willbpeters/plumb/docs/superpowers/specs/2026-09-15-putting-analyzer-design.md

# Grip-Mounted Putting Stroke Analyzer — Design Specification

**Working name:** Plumb
**Date:** 2026-09-15
**Author:** Will Peters
**Status:** Approved for planning

---

## 1. Overview

A self-contained, battery-powered sensor that mounts in the butt of a putter grip and reports
stroke metrics on an onboard round display immediately after each putt. No phone, no app, no
network connection.

The device consists of two physically separate parts:

- A **puck** — the electronics, display and battery, shared across all putters.
- A **base** — a cheap printed part that is installed semi-permanently in each putter and
  carries the angular index the puck seats against.

The engineering substance of the project is not the hardware. It is the derivation of putter
face orientation from a single 6-axis IMU mounted a meter away from the face, and the
empirical validation of that derivation against an independent reference system.

### 1.1 Goals

1. Report **face angle at impact**, **tempo ratio**, and **stroke path** within 500 ms of
   follow-through, on-device.
2. Achieve validated face-angle accuracy sufficient for coaching use (see §3).
3. Produce a published accuracy study covering blade, mallet and zero-torque putters.
4. Move between putters in under ten seconds with no recalibration.

### 1.2 Non-goals

These are explicitly out of scope and will not be built:

- Companion mobile application.
- Cloud sync, accounts, or session history beyond on-device storage.
- Wi-Fi connectivity of any kind. The radio is disabled in firmware.
- Green reading, break estimation, or make/miss prediction.
- Full-swing (non-putting) analysis. Load cases and sample rates differ substantially.
- Absolute face angle relative to the target line. See §3.3.
- **Numeric quality, skill or "putt score" ratings.** Report, never judge. A device
  that grades a stroke asserts a standard, and 1.8° open is a miss for a tour player and
  a fine putt for most people. The number is reported and the graphic carries the
  intuition. Written into the contract here because a competitor ships a 0–100 score and
  the idea will be re-proposed otherwise — see the 2026-09-22 competitive feature review.

### 1.2.1 Deferred — considered, postponed, not rejected

Distinct from §1.2: these are wanted, but not in the first build.

**Putt distance approximation.** Calibrate before a round by striking putts at a few known
paces — say 5, 10 and 15 — and thereafter estimate distance from the measured stroke.

The measurement side is nearly free. Clubhead speed at impact falls out of `v = ω × r`, the
same relation §7.4 already uses for path, so the device can report impact speed today at no
extra cost. **Impact speed is therefore not deferred — it is a first-build metric.**

Mapping speed to *distance* is the hard part, and it is deferred because it is a different
kind of problem from everything else in this spec. Face angle and tempo are properties of the
putter that a rigid-body argument makes exactly recoverable. Distance is a property of the
**ball, the strike and the green**, and the device measures none of them:

- **Strike quality.** A toe or heel hit transfers less energy for the same clubhead speed. The
  device cannot see where on the face contact happened.
- **Green speed.** The same stroke runs very differently on a Stimp 8 green and a Stimp 12.
- **Slope.** Uphill and downhill change the answer entirely.

Per-round calibration handles green speed, which is why the proposed approach is sound — it
calibrates the one unknown that stays constant for a round. It cannot handle strike quality or
slope.

So it should be built as an **approximation, labelled as one**, and its accuracy target set
after measurement rather than before. It would also be the first metric in this device whose
accuracy depends on the golfer's consistency rather than on the instrument, which is worth
being clear about before it ships.

**Metrics the pipeline nearly already produces.** A 2026-09-22 review of Plus Putt Path
(`2026-09-22-competitive-feature-review-design.md`) found several quantities this device
computes internally and discards. They are listed here rather than in the first build because
promoting them is a scope decision, not a technical one. None requires new sensing.

- **Face-to-path differential.** Face angle minus path direction; both already in
  `StrokeResult`. It is what determines where a putt starts, and it is a relationship between
  two things the device measures rather than a measurement against a reference it lacks. It
  does NOT escape §3.3 — an address-squareness error biases the face term and not the path
  term, so nothing cancels.
- **Face rotation rate at impact.** The gyro reading at the impact sample projected onto
  measured gravity: one dot product, and **no integration at all.** Every other metric here is
  an integral whose budget is dominated by drift; this one is a direct reading of the
  best-characterised channel against a measured 0.22–0.24 dps floor. It may be the most
  accurate number the device can produce. Reporting it is not a putter-type prior — invariant 1
  forbids the algorithm keying off rotation, not the device reporting it.
- **Total face rotation through the stroke.** `twist_angle` over a different interval.
- **Absolute stroke timings.** Backstroke and forward-stroke milliseconds, time to contact, and
  the pause at the top. The state machine has the indices. `StrokeResult` now reports the two
  phase durations as well as their ratio, for the tempo screen; time to contact and the pause
  at the top are not kept. Timing is this device's best-validated axis.
- **Backswing and follow-through length, and their ratio.** Same track machinery as path, but
  far better conditioned: the integration noise that inflates a 6 mm arc is negligible against
  a backswing of a few hundred millimetres. The RATIO is better still, because a pivot-offset
  error scales both lengths nearly equally and largely cancels — so it may be reportable while
  the arc is not. Measure before claiming.
- **Left-handed mirrored mode.** Every screen is framed "left is the target"; for a left-handed
  golfer that is backwards. Pure UI, and a genuine gap rather than a nice-to-have.
- **Compare-to-first-stroke, and local session history.** Permitted by §1.2, which rules out
  cloud sync, accounts and history *beyond* on-device storage — not on-device history itself.

### 1.3 Project positioning

This is a portfolio project whose purpose is to demonstrate depth in embedded systems,
sensor fusion and empirical validation. Where a choice exists between a faster path and a
more defensible one, the more defensible one wins. A finished device with unvalidated
numbers does not satisfy the goal.

---

## 2. Physical principle

For a rigid body, angular velocity is identical at every point. The grip end of a putter
rotates at exactly the same rate as the face, with no dependence on the distance between them.

Consequently:

| Metric | Requires putter geometry | Rationale |
|---|---|---|
| Tempo ratio | No | Pure timing |
| Face angle at impact | No | Angular velocity is position-invariant |
| Stroke path | **Yes** | Translation scales with the sensor-to-face lever arm |

Face angle and tempo are therefore putter-agnostic and require only the fixed rotational
offset between the sensor axes and the face normal. Path requires the lever arm vector `r`
from sensor to sweet spot, which is a per-putter quantity.

For a point P offset by `r` from the sensor S on a rigid body:

```
a_P = a_S + ω̇ × r + ω × (ω × r)
```

This relation is used in two places: to propagate motion from the sensor to the face when
computing path (§7.4), and inverted, to estimate `r` itself during optional auto-calibration
(§8.4).

### 2.1 Putter type is a data difference, not a calibration difference

A zero-torque putter places the head's center of gravity on the shaft axis, so the head has
no inherent tendency to rotate open and closed through the stroke. A blade or face-balanced
mallet places the CG off-axis and does rotate.

This is a difference in the motion the device measures, not in how the device should measure
it. The algorithm must therefore contain **no putter-type priors**: no normalization of face
rotation against expected magnitude, and no segmentation thresholds tuned on rotation
amplitude. A zero-torque putter that produces low face rotation is reporting a correct
result, not a degraded one.

The only per-putter quantities in the system are the clocking offset and the lever arm.

---

## 3. Success criteria

All figures are measured against the reference system described in §10, over the study
design in §10.3.

| Metric | Target |
|---|---|
| Face angle, bias vs reference | ≤ 0.5° |
| Face angle, 95% limits of agreement | ≤ ±1.0° |
| Face angle, test–retest repeatability (remount, same putter) | ≤ 0.5° SD |
| Tempo ratio, absolute error | ≤ 0.05 |
| Path arc magnitude, relative error | ≤ 10% |
| Path direction classification (straight / in-out / out-in) | ≥ 95% agreement |
| Stroke detection, true positive rate | ≥ 98% |
| False stroke triggers | ≤ 1 per 30 min of idle handling |
| Result latency after follow-through | ≤ 500 ms |
| Strokes per charge | ≥ 500 |
| Putter changeover time | ≤ 10 s |

### 3.1 Why path has a looser target

Path is derived from translation, which requires integrating acceleration. Integration of
noisy acceleration accumulates error quadratically in time. A 10% arc-magnitude target is
honest for this sensor placement; a tighter claim would not survive validation.

### 3.2 Why repeatability is listed separately

Test–retest repeatability isolates mounting error from algorithm error. If bias against the
reference is acceptable but repeatability is poor, the mechanical index is at fault, not the
math. These are separately actionable, so they are separately measured.

### 3.3 Declared limitation: face angle is relative to address

The device has no external heading reference. Gravity constrains pitch and roll absolutely
but provides no information about heading, and a magnetometer is unusable next to a steel
putter head.

The device therefore measures **face angle relative to the address position**, treating the
face at address as square. A golfer who addresses the ball with the face 2° open will be
told they delivered a square face on a putt that starts 2° right.

This limitation is inherent to grip-mounted sensing without an external reference. It will be
stated in the user-facing documentation and in the accuracy study, not hidden. An optional
per-putter "square to line" routine (§8.3) lets a user establish an absolute reference against
an alignment stick if they want one.

---

## 4. Hardware

### 4.1 Bill of materials

| Item | Part | Qty | ~Cost |
|---|---|---|---|
| MCU / display / IMU board | Waveshare ESP32-S3-Touch-LCD-1.28 | 1 | $25 |
| Battery | 3.7 V 400 mAh LiPo, protected (PCM), MX1.25 1.25 mm connector | 1 | $8 |
| Retention magnets | N52 neodymium discs, 4 × 6 mm | 4 | $2 |
| Puck shell | PETG, printed | 1 | ~$1 |
| Base | PETG, printed | 1 per putter | ~$0.30 |
| **Total (device + 3 bases)** | | | **~$37** |

### 4.2 Board resources

| Resource | Value | Allocation |
|---|---|---|
| MCU | ESP32-S3R2, dual-core Xtensa LX7 @ 240 MHz | Core 0: sensor. Core 1: UI. |
| Internal SRAM | 512 KB | LVGL draw buffers, IMU ring buffer, stack |
| PSRAM | **2 MB quad-SPI** | Fonts and image assets only — not framebuffers |
| Flash | 16 MB | ~2 MB application, ~13 MB LittleFS stroke log |
| Display | 240×240 round, GC9A01 over SPI | 80 MHz, DMA |
| IMU | QMI8658 6-axis, I²C @ 400 kHz on GPIO6/7 | Output registers polled, INT on GPIO3/4 (§6.4, amended) |
| Touch | CST816S, shares the I²C bus | Polled only outside the stroke window |
| Battery sense | GPIO1, 200 K/100 K divider | `V = 3.3/4096 × 3 × adc` |
| Charger | ETA6096 over USB-C | Charge current must be ≤1C for the fitted cell; verified against the board schematic at bring-up |

### 4.3 Power budget

Active draw is approximately 70–100 mA (CPU at 240 MHz, backlight on, LVGL rendering, IMU at
896.8 Hz). A 400 mAh cell yields roughly 4–5 hours of continuous operation. The range was
estimated when the stroke rate was 500 Hz; what the higher rate adds is not yet measured
(§6.4, amended).

Because the device sleeps between strokes (§9), realistic practice use is measured in weeks
rather than hours. The ≥500 strokes-per-charge target in §3 is set against the sleep-enabled
duty cycle, not continuous operation.

The GPIO1 sense divider draws ~14 µA continuously across the battery, approximately 10 mAh
per month. This is accepted, not mitigated.

### 4.4 Battery integration hazards

These are build-time hazards with permanent consequences and are called out explicitly:

1. **Connector pitch.** The board accepts MX1.25 (1.25 mm). Most hobby LiPo cells ship with
   JST-PH (2.0 mm), which will not mate. Source a cell with the correct connector.
2. **Polarity.** Two-pin LiPo polarity is not standardized between vendors. Meter the cell
   against the board silkscreen before first connection. If reversed, re-pin the housing by
   lifting the retention tab; do not cut and splice.
3. **Never cut both battery leads simultaneously.** Cut one at a time.
4. **Charge rate.** The ETA6096 is rated to 800 mA but the programmed current is set by a
   board resistor. Read the Waveshare schematic and confirm charge current ≤ 1C for the
   chosen cell. If the board is set to 500 mA, a 400 mAh cell is at 1.25C and a larger cell
   should be used.
5. **Protection circuit.** Only cells with an integrated PCM are acceptable.

*Amended 2026-09-26.* Item 4 and the charger row in §4.2 name the ETA6096. The Waveshare Rev3
schematic, read at display bring-up as item 4 asks, shows an **ETA6098**, with R15 = 160 kΩ,
which the schematic's own table maps to **1 A** charge current. The 400 mAh cell in §4.1 would
charge at 2.5C, so it fails item 4 as written: fit a cell of at least 1000 mAh, or change R15.
Read from the schematic's table, not the chip datasheet, and not yet measured on the bench;
the board's revision still needs confirming against its silkscreen. Recorded in
`docs/bringup-results.md`.

---

## 5. Mechanical design

### 5.1 Two-part architecture

**Base** (one per putter, installed once):

- Anchors into the grip butt hole via a **barbed taper**, chosen over a thread because grip
  butt holes vary in diameter between manufacturers and a barb tolerates that variation.
- Presents a **D-shaped key** on its upper face.
- Carries four magnet pockets.

**Puck** (one total, moves between putters):

- Printed shell housing the board and cell, with a D-shaped socket in its base and matching
  magnets.
- USB-C port exposed through a shell cutout for charging.

Separation of concerns: the barb anchors, the D-key indexes, the magnets retain. No single
feature does two jobs.

### 5.2 Why magnets are safe here

The QMI8658 is a 6-axis part with no magnetometer. Magnetic retention would destroy the
heading estimate of a 9-axis sensor, but this design has already abandoned magnetic heading
because a steel putter head makes it unusable. The two constraints cancel.

### 5.3 Clocking: mechanical repeatability, software truth

A barbed or threaded base seats at an arbitrary rotation. This is not corrected mechanically.

- The **D-key provides repeatability** — the puck returns to the same angular position on
  every remount.
- A **stored software offset provides accuracy** — measured once per putter via the routine
  in §8.3, and valid indefinitely because the base does not move.

This eliminates the need for a lockable two-piece hub with a set screw. If field experience
shows bases loosening and rotating, the mechanical version becomes a v2 item.

### 5.4 Mass

Base ~3 g, board 13 g, cell ~7 g, shell ~7 g — approximately **30 g**, standing roughly 20 mm
proud of the butt. This is mild counterbalancing and is generally perceived favorably.

Because the same puck is used on every putter, added mass is a controlled constant across the
validation study rather than a per-putter confound.

**Corroborated externally.** Plus Putt Path, a shipping grip-mounted analyser, is 33 g (24 g
device + 9 g adapter). A commercial product landing within 10% of this estimate is evidence
the budget is realistic rather than optimistic.

### 5.5 Primary mechanical risk: mount compliance

The base anchors into rubber. The device must resolve 1° through an impact shock event, and
any compliance between the base and the shaft means the IMU partly measures the plug flexing
rather than the putter rotating. A compliant mount also introduces a mechanical resonance
inside the signal band, which corrupts impact detection specifically.

**This is the highest-risk unknown in the build and is resolved empirically, not by
assumption.**

**Tap test procedure:** mount the puck, log raw IMU at maximum rate, strike the putter head
with a soft mallet, and take an FFT of the ringdown.

- Resonance above ~500 Hz → mount is effectively rigid. Proceed.
- Resonance below ~200 Hz → mount is unacceptably compliant. Escalate.

**Escalation path:** open the grip butt hole with a step drill and anchor an expanding collet
into the steel shaft bore (~.580" ID). This is rigid but destructive to the grip and cannot be
used on borrowed or demo putters.

**Third option, between the two: a manufacturer-designed port.** SuperStroke Tech Port grips
ship with a port in the butt intended to accept a sensor. It is more rigid than a barb in
rubber, non-destructive, and available to anyone who buys that grip — found via a competitor
that lists compatibility with it (2026-09-22 competitive feature review).

This does NOT replace the barbed taper, because §5.6's whole point is tolerating grips the
project does not control. Its value is as a **rigid reference for the tap test**: run §5.5
against both mounts and the test stops being pass/fail and becomes a comparison, with the
barb's compliance measured against a known-good mount rather than judged against a threshold.
If the barb fails, it is also an escalation path that destroys nothing.

### 5.6 Grip compatibility survey

Before the base geometry is finalized, the butt-end construction of every putter in the study
must be inspected. Many putter grips ship with a sealed or pinhole butt cap, and zero-torque
grips are frequently non-round. A base design premised on an open, round, concentric hole
will not fit all three study putters.

---

## 6. Firmware architecture

### 6.1 Platform

ESP-IDF with FreeRTOS. Chosen over Arduino for explicit task scheduling, core pinning and
timer control, all of which are load-bearing for sampling determinism.

LVGL 9.2 or later for the UI. Version 9.0 carried a documented ~37% performance regression on
ESP32-S3 relative to 8.3.9; 9.2+ recovers most of it and adds ESP32-S3 assembly-optimized
blending.

### 6.2 Core assignment

Graphics and sensor acquisition never compete for the same instant, and this is enforced
structurally:

- **Core 0** — IMU acquisition task. Paced by the IMU's data-ready line, high priority,
  writes to a lock-free ring buffer. Nothing else runs on this core during a stroke.

  *Amended 2026-09-27.* This previously read "Hardware-timer driven". A timer runs on the
  ESP32's clock and the IMU on its own, and this unit's IMU runs at 906.86 Hz against a nominal
  896.8 (§6.4), so a timer at the nominal rate would duplicate or miss about one sample in a
  hundred. Acquisition is paced by the IMU's own data-ready line instead: DRDY on INT2 →
  GPIO3, which wakes the task. The part runs in SyncSample mode, whose lock stops a ~500 µs
  I²C read from being torn by the next sample (datasheet rev A §6.1, §6.3, §13.2). Two
  register facts that rev A gets wrong or leaves ambiguous are recorded in
  `docs/bringup-results.md`: INT2 needs `CTRL1` bit 4, which rev A marks reserved, and the
  CTRL9 handshake needs `CTRL8.bit7`.

  Measured on the firmware skeleton (`firmware/`, 2026-09-27): zero samples lost in 60 s at
  rest (54,653 samples, 906.93 Hz, counted from the sensor's own sample counter, read by
  `capture.py` unchanged). With the UI rendering continuously, the median time from DRDY edge
  to read complete rose from 699 to 926 µs, and its maximum reached 1148 µs, past the 1103 µs
  sample period. Rendering and streaming together lost 391 of 54,568 samples (0.72%). With
  the gate below armed, the same load lost none (54,720 samples), with latency p99 707 µs and
  maximum 820 µs. The rule in the next paragraph is therefore measured, not assumed.

  The cause was then found (`docs/bringup-results.md`, "Where rendering's delay comes from").
  Rendering on core 1 evicted the I²C driver's code from the cache the two cores share. With
  the driver run from IRAM, the median read latency while rendering equals the armed median,
  and streaming while rendering lost 0 of 55,064 samples. What is left is touch polling on the
  shared bus, which the gate already suspends during a stroke. So the gate is no longer the
  only thing preventing loss, but it remains what keeps the stroke's timing tail at its floor.
- **Core 1** — LVGL rendering, UI state, storage writes, power management.

During an armed stroke, the UI renders nothing. The screen displays a result only after
follow-through completes, when nobody is looking at it anyway. This removes rendering as a
source of sampling jitter entirely.

**The stroke is armed from BACKSWING through FOLLOWTHROUGH**, and the stroke pipeline itself
arms and opens the gate. It runs on core 1 as the ring is drained, so its end-of-stroke
computation never delays a read on core 0.

*Amended 2026-09-28 (Will's decision).* "Armed" was not defined. Arming at ADDRESS would freeze
the screen, swipes included, whenever the putter was still — lying on a table included —
because still is what ADDRESS means. Arming at BACKSWING confirmation leaves the stroke's first
~45 ms (onset, plus the confirmation hold) sampled with the gate open. Since the I²C driver
moved to IRAM that costs a timing tail, not samples: rendering while streaming lost 0 of 55,064.

### 6.3 Display configuration

```
CONFIG_ESP_DEFAULT_CPU_FREQ_MHZ_240=y
CONFIG_ESPTOOLPY_FLASHFREQ_120M=y          # QIO
CONFIG_COMPILER_OPTIMIZATION_PERF=y
CONFIG_LV_ATTRIBUTE_FAST_MEM_USE_IRAM=y
CONFIG_LV_MEMCPY_MEMSET_STD=y
# SPI LCD at 80 MHz with DMA
# LVGL draw buffers: 2 × (240 × 60) RGB565 = 57.6 KB, internal DMA-capable SRAM
# Display refresh period: 10 ms
# Wi-Fi: disabled
```

Draw buffers are placed in internal SRAM rather than PSRAM. Published benchmarks that favor
PSRAM framebuffers on this display use 8 MB octal PSRAM; this board carries 2 MB quad PSRAM at
roughly half the bandwidth, where internal SRAM wins. Espressif's guidance of 10–25% of screen
resolution per buffer, double-buffered, is followed.

**LVGL's code runs from flash (`CONFIG_LV_ATTRIBUTE_FAST_MEM_USE_IRAM` off), and its heap is
32 KB, not 96.**

*Amended 2026-09-28 (Will's decision).* The block above previously set
`CONFIG_LV_ATTRIBUTE_FAST_MEM_USE_IRAM=y`. The stroke pipeline needs 157 KB of internal SRAM in
single precision, 130 KB of it the 3 s path buffer, and only 38.7 KB was free. LVGL held
211 KB: 112 KB of code copied into IRAM, and a 96 KB static heap that peaked at **9,968 bytes**
on the board, measured twice with every screen cycled for 20 s. Moving the code to flash and
the heap to 32 KB (3.2× the peak) left 204 KB free. It did not fit as one block: the S3's
internal heap is several regions, and the largest was 127–139 KB. The path buffer is therefore
allocated as separate pieces. The alternative, the path buffer in PSRAM, would have amended
invariant 7 instead.

The cost, measured on the board with the same instrument before and after (`lv_timer_handler`
duration while cycling screens, 20 s):

| | Draws | Mean | Max |
|---|---|---|---|
| LVGL in IRAM, 96 KB heap | 1,362 | 14.05 ms | 16.32 ms |
| LVGL in flash, 32 KB heap | 1,290 | 14.83 ms (+5.6%) | 18.30 ms |

Rendering happens only with the gate open (§6.2), never during a stroke, so its speed costs
result latency and not sampling.

### 6.4 IMU acquisition

- Sample rate: **896.8 Hz** during an armed stroke, **112.1 Hz** while monitoring for address.

  *Amended 2026-09-21.* This previously read 500 Hz and 100 Hz. Neither exists on
  the QMI8658, whose ODR steps derive from the gyro's natural frequency rather
  than from round numbers: 28.025, 56.05, 112.1, 224.2, 448.4, 896.8, 1793.6,
  3587.2, 7174.4 Hz. The choice for the stroke rate was between the two
  neighbours of 500 Hz, and 896.8 was taken rather than the nearer 448.4 on
  measured evidence — the synthetic harness found tempo ratio to be the binding
  accuracy constraint, with far less headroom than face angle, and tempo error
  scales directly with sample resolution. Doubling the rate roughly halves it and
  quarters the integration error.

  The cost is current draw, which is **not yet measured**: this board has battery
  voltage sense but no current sense, so it needs an inline power meter. It is
  bounded by duty cycle — the device sleeps between strokes (§9), so the higher
  rate runs only during the ~1.5 s a stroke is being measured. If the §4.3 power
  budget or the ≥500-strokes-per-charge target in §3 later proves tight, 448.4 Hz
  is a one-constant change back.
- **The nominal rate is the setting, not the rate. The firmware measures the real rate at
  startup, and the pipeline integrates with the measured value.**

  *Amended 2026-09-28.* The QMI8658's ODR comes from its own
  MEMS oscillator. This unit runs **1.12% fast** (906.86–906.94 Hz against 896.8), and a rate
  error is a scale error in every integrated angle that no filtering removes. It is a property
  of the part, not the part number, so no shared constant can carry it; a per-unit constant
  was the alternative and was rejected (Will, 2026-09-27) because the rate also moves:

  | Measured on this unit | Rate |
  |---|---|
  | 2026-09-21, imu_stream, 20–60 s captures | 906.86 Hz ± 0.01 |
  | 2026-09-27, product firmware, 60 s | 906.93 Hz |
  | 2026-09-28, cold boot | 906.9249 Hz |
  | 2026-09-28, 30 back-to-back startup measurements, warm | 906.9314 Hz, SD 0.28 ppm, range 1.0 ppm |

  About 75 ppm between days and 7 ppm of warm-up — each negligible against the 11,200 ppm
  being corrected (100 ppm is 0.001° on a 10° rotation), but proof a stored constant goes
  stale.

  *How* (`firmware/components/acq/src/rate.c`): a least-squares line through (sample index
  from the sensor's own counter, DRDY edge time from `esp_timer`) over the first 1,024 samples
  after boot (~1.13 s), with mispaired edges skipped or rejected. Its statistical error is
  ~3×10⁻⁵ Hz; the measurement is bounded instead by the oscillator's own wander (1 ppm within
  a session) and by the **ESP32-S3 crystal `esp_timer` counts against, which it cannot see
  from inside**. Timed against a PC's clock instead, the same unit read 13.4 ppm higher — two
  crystals disagreeing by an ordinary amount; that check bounds their difference and cannot
  say which is right. Total rate uncertainty: **of order 15 ppm**, three orders of magnitude
  inside what it replaces. Re-checked with `analysis/tools/rate_check.py`.
- Full-scale ranges: gyro **±256 dps**, accelerometer ±16 g.

  *Amended 2026-09-21.* This previously read ±250 dps, which the QMI8658 cannot
  produce. Its gyro full-scale table is powers of two — ±16, 32, 64, 128, 256,
  512, 1024, 2048 dps. ±250 is an InvenSense convention and was carried across in
  error. Confirmed against the QST datasheet (rev 0.9 and rev A), which also
  quotes 128 LSB/dps at ±256 dps — and 256 × 128 = 32768 exactly, which fixes the
  full-scale divisor at 2^15 rather than at INT16_MAX. Configuring the part at
  ±256 while converting counts at ±250 would have made every recovered rate 2.4%
  low: a systematic scale error in every integrated angle, invisible without a
  reference. `FullScale` in `analysis/plumb/sensor.py` is amended to match.
- **Stroke acquisition polls the output registers directly. The FIFO is not used during a
  stroke.**

  *Amended 2026-09-21 (second amendment to this section).* This previously read "FIFO batching
  is mandatory", justified by a 12-byte burst read costing ~325 µs on a 400 kHz bus, single-sample
  polling consuming ~16% of it, and batching reducing that "by an order of magnitude". The
  arithmetic does not hold and the hardware disagrees.

  The arithmetic: batching reduces *transaction overhead*, not *data volume*, and at 12 bytes per
  sample the volume dominates. 896.8 Hz × 12 B is ~25% of a 400 kHz bus however it is read.
  Direct polling costs more — ~44%, from an 18-byte block read plus a 3-byte status poll — but
  not an order of magnitude more, and I²C on this part is capped at 400 kHz (datasheet rev A,
  Table 38), so the difference cannot be bought back with bus speed.

  The hardware, measured on the board over 60 s at rest, both paths back to back:

  | | Direct registers | FIFO |
  |---|---|---|
  | Samples delivered | 54720 | 42560 |
  | Sensor ODR, measured | **906.86 Hz** | not measurable — see below |
  | Delivered rate | 906.86 Hz | 707.80 Hz, **21.9% below** what the sensor produced |
  | Samples lost | **0** | overflow flag set on 665 of 665 batches |
  | Resting gyro σ, worst axis | **0.2765 dps** | 0.3405 dps, and varying with position in the batch |

  Three reasons the FIFO loses that fifth, all from the datasheet and all confirmed on hardware.
  FIFO read mode suspends acquisition — FIFO_CTRL bit 7 "must be cleared again after the data read
  is complete *so that writing data to the FIFO can resume*" — so every microsecond spent draining
  is samples the part never stores. The loss fraction depends only on ODR and bus clock, so no
  watermark helps. And the TIMESTAMP counter does not advance while the FIFO is enabled, which
  means the FIFO path cannot count what it lost: it reports that loss happened and never how much.

  **What this does not solve: the §5.5 tap test.** Direct polling costs ~500 µs per sample against
  a 139 µs period at the 7174.4 Hz maximum ODR, so it cannot service the rate the tap test needs,
  and the FIFO cannot deliver uniformly sampled data for an FFT. The tap test remains blocked. The
  untried option is 1793.6 Hz — Nyquist 896 Hz, enough to see the resonance §5.5 looks for — with
  the timestamp block dropped from the read to buy headroom.
- **Touch polling is suspended between arm and follow-through completion.** The CST816S shares
  the I²C bus and would otherwise steal bus time during the measurement window. This tightens
  under direct polling: the margin at 896.8 Hz is ~56% of the sample period, and a sample missed
  is a sample gone — there is no buffer to absorb a late read.

Accelerometer saturation at impact is expected and acceptable. Impact is used as a trigger,
not as a measurement; a clipped spike is a cleaner edge than an unclipped one.

The board commits the IMU to I²C. If a future revision requires sustained rates above 1 kHz,
that is the argument for a custom PCB with an SPI-connected IMU, and is out of scope here.

---

## 7. Signal processing

### 7.1 State machine

```
SLEEP → IDLE → ADDRESS → BACKSWING → DOWNSWING → IMPACT → FOLLOWTHROUGH → COMPUTE → DISPLAY → IDLE
```

| State | Entry condition |
|---|---|
| SLEEP | 60 s in IDLE with no motion |
| IDLE | Wake-on-motion interrupt from QMI8658 |
| ADDRESS | Gyro variance below threshold for 500 ms |
| BACKSWING | Sustained \|ω\| above threshold, consistent sign |
| DOWNSWING | Dominant-axis angular velocity sign reversal |
| IMPACT | Acceleration magnitude spike above threshold |
| FOLLOWTHROUGH | \|ω\| below threshold for 300 ms |

Entering ADDRESS captures two things: the gravity vector `g₀`, and the gyro bias `b` as the
mean angular rate over the stillness window. Sampling steps to 896.8 Hz on ADDRESS entry.

**A stroke that does not reach IMPACT is abandoned**: no result, and the next stroke starts
from IDLE.

| Exit | Condition | From |
|---|---|---|
| ABANDONED (rest) | The stillness window fails the ADDRESS stillness test, then passes it again | ADDRESS, BACKSWING, DOWNSWING |
| ABANDONED (timeout) | Longer than a maximum stroke duration since backswing onset | BACKSWING, DOWNSWING |
| DONE, path unavailable | The same timeout, after impact | FOLLOWTHROUGH |

*Amended 2026-09-28 (Will's decision).* The state machine above previously only ran forward.
A real device sees practice strokes with no ball, putters picked up after address, waggles,
re-grips, and walks to the ball. Each of these starts a stroke that never reaches impact, and
the machine waited in DOWNSWING indefinitely for an impact that never came, with rendering
suspended (§6.2).

- **Rest is the ADDRESS test, run in both directions.** The window must first fail the
  stillness test and then pass it again. Passing it once motion has merely been seen is not
  enough. At backswing onset the 0.5 s window is still almost entirely address stillness, and
  the first implementation abandoned every real stroke at its first samples. The window
  cannot pass again until the motion has slid out of it.
- **Rest applies at ADDRESS too.** A waggle or re-grip that settles again leaves `g₀`, `b` and
  the attitude's zero describing a position the golfer has left. Face angle is relative to
  address (§3.3), and the address that matters is the one the stroke starts from. Stillness
  at address with no motion never fails the test, and changes nothing.
- **After impact the stroke is committed.** Face angle, tempo and impact speed are all fixed
  at impact. A follow-through that never goes quiet, such as walking off still swinging the
  putter, has no motion end to measure path to. The stroke is therefore finished with path
  reported unavailable, rather than measured over the walk.
- **The maximum stroke duration is a threshold, like every other**, and is unnumbered here for
  the same reason (§7.6).

Tested against continuous synthetic streams (a practice stroke with no impact followed by a
putt; a waggle, then a putt): the putt's face angle, tempo and speed match ground truth, and
the C port makes the same decisions as the Python (`analysis/tests/test_session.py`,
`test_c_session.py`).

*Note, 2026-09-29, not an amendment.* A parallel change (commit `bc2d3d7`) instead re-took
`g₀` and `b` from the last still window before the back-extrapolated onset, and replayed the
samples since. The exits above were kept because they are ported and running on the board.
Two cases it covered are still open under them, each a strict xfail in
`analysis/tests/test_pipeline.py`:

- **A slow re-aim.** One that never fails the 0.5 s stillness test is never re-captured: 2°
  over 2 s reads 1.88° on a square stroke. A 2° re-aim over 0.5 s is re-captured correctly.
- **A long address.** Attitude integrates from first stillness, so the window §7.2 relies on
  becomes address time plus stroke time: 0.34° worst after a 10 s address, against under
  0.04° after 1 s.

**Also open, and measurable on the board in hand:** §6.4 monitors at 112.1 Hz and steps to
896.8 on ADDRESS entry. Whether the QMI8658's gyro bias depends on its ODR and filter setting
is not known. If it does, a bias taken during monitoring must never be used during a stroke.
The harness runs at stroke rate throughout and cannot see this.

All detection thresholds referenced above are deliberately left unnumbered here. They are
derived empirically from the logged stroke corpus during Phase 2 and fixed in the Python
notebook before the algorithm is ported to C (§7.6). Choosing them analytically ahead of real
data would be guessing, and thresholds tuned on rotation amplitude in particular would
reintroduce the putter-type priors prohibited in §2.1.

### 7.2 Orientation estimation

Orientation is obtained by integrating bias-corrected angular velocity `(ω − b)` from the
address attitude, which is itself initialized from `g₀`. The integration step is the reciprocal
of the rate **measured at startup**, not of the nominal ODR (§6.4, amended 2026-09-28).

**Accelerometer correction is heavily down-weighted during the stroke.** This is the single
most important implementation detail in the pipeline. A stock Madgwick or Mahony filter
assumes the accelerometer reads gravity; during a putting stroke it reads gravity plus stroke
acceleration, and a naive filter will be dragged off attitude by the motion it is supposed to
be measuring. The correction gain is set near zero between BACKSWING and FOLLOWTHROUGH, and
restored in IDLE and ADDRESS.

Gyro drift is bounded not by accelerometer correction but by the **short integration window**.
Bias is nulled at address and integration runs for roughly 1.5 s, so drift has no time to
accumulate. This is why per-stroke bias nulling (§8.5) is non-optional.

### 7.3 Face angle at impact

```
q_rel      = q_impact ⊗ q_address⁻¹
face_angle = project(q_rel, ground plane defined by g₀) + clocking_offset
```

The ground plane comes from the measured gravity vector at address, so shaft lie angle is
handled implicitly. Lie angle is never entered by the user and never stored; it is measured
on every stroke.

### 7.4 Path

Face-point velocity is obtained from `v_face = ω × r` using the stored lever arm, integrated
over the stroke window to produce a horizontal displacement track. Path is classified as
straight, in-to-out or out-to-in by comparing lateral displacement before and after impact,
and arc magnitude is reported alongside the classification.

Direction classification is the primary output and is held to a 95% agreement target.
Arc magnitude is secondary and held to 10%.

*Amended 2026-09-25.* `v_face = ω × r` assumes the sensor does not translate. It does: the
stroke rotates about the golfer's hands, so the face travels on `r + d`, where `d` runs from
the pivot to the sensor — 1.4 m against the 0.85 m lever arm, and exactly the 61% arc shortfall
measured on the harness. `d` is estimated per stroke by least squares, from the velocity form
of the rigid-body relation, `∫ R a dt = R [ω]ₓ d − v₀`, with `v₀` eliminated by centring and
the gyro noise's contribution to the design matrix (measured in the ADDRESS stillness window)
subtracted. It is accumulated across strokes as a per-golfer calibration. The acceleration
form, `a = ω̇ × d + ω × (ω × d)`, was implemented first and replaced: differentiating the gyro
put enough noise into the design matrix to bias the least-observed direction of `d`, which on
an arced putter turned face rotation into sideways path (1.142 of true arc against 1.010 for a
straight putter at lie 5, 0.28 dps; now 1.010 and 1.006). The same argument applies to §8.4's
Version 2, which is written in the acceleration form. Arc is measured over the motion only,
from stroke onset to the start of the follow-through hold, not over the stillness around it.
Measured on the synthetic harness only; not yet on a real stroke.

### 7.5 Tempo

```
tempo_ratio = (t_transition − t_backswing_start) / (t_impact − t_transition)
```

Two timestamps from the state machine. No fusion, no geometry. This is expected to be the
first metric working end-to-end and should be used to prove out the segmentation pipeline
before face angle is attempted.

### 7.6 Development workflow

The algorithm is **developed in Python against logged strokes, then ported to C.** Numerical
methods are not debugged on a device with a 1.28" screen and no debugger.

1. Firmware logs raw IMU to LittleFS.
2. Strokes are dumped over USB to CSV.
3. Segmentation and fusion are developed in a Jupyter notebook against the recorded corpus.
4. The settled algorithm is ported to C and re-verified against the same corpus.

The notebook and the stroke corpus are committed to the repository. They are part of the
deliverable, not scratch work.

---

## 8. Calibration model

Three tiers, at three different frequencies. The two-part mount collapses what would
otherwise be a separate per-installation tier into the per-putter profile.

| Tier | Corrects | Frequency | Storage |
|---|---|---|---|
| Device | Gyro and accelerometer bias and scale factor | Once per device | NVS |
| Putter profile | Clocking offset, lever arm `r` | Once per putter | NVS |
| Stroke | Gyro bias null, gravity reference | Every stroke | RAM |

### 8.1 Device calibration

Standard 6-position tumble test. The device is rested on each of six faces of a printed
fixture; accelerometer bias and scale are solved per axis, and gyro bias is captured while
stationary. Run once at build time and stored permanently.

### 8.2 Putter profiles

Profiles are stored in NVS and selected on-device. Each holds a name, a clocking offset, and a
lever arm vector. Profile switching is the only user action required when changing putters.

### 8.3 Clocking offset

Square the putter face against an alignment stick, hold still, confirm. The measured heading
becomes the profile's clocking offset.

This runs once per putter. Because the base remains in the grip, the offset stays valid across
remounts, which is the central benefit of the two-part mechanical design.

### 8.4 Lever arm

**Version 1 — manual.** The user selects putter length and head type from a list; a default
lever arm is derived. Approximately 90% of achievable path accuracy for a very small fraction
of the effort. This ships first.

**Version 2 — automatic.** With the putter head resting on the ground as a fixed pivot,
`a_face = 0`, so:

```
a_sensor = −( ω̇ × r + ω × (ω × r) )
```

The user waggles the grip for five seconds and the three components of `r` are recovered by
least squares over the collected samples. Convergence behavior is plotted and included in the
write-up.

Version 2 is a v2 feature and does not gate any milestone.

### 8.5 Per-stroke calibration

Gyro bias is re-nulled and the gravity reference re-captured during every ADDRESS stillness
window. This is what keeps orientation integration bounded (§7.2) and is not optional.

---

## 9. Power management

There is no power switch. The battery connects directly, and idle drain is managed in
firmware.

The QMI8658's wake-on-motion feature drives an interrupt on GPIO3/GPIO4. The ESP32-S3 enters
deep sleep after 60 s of stillness and wakes when the putter is picked up.

The resulting interaction has no buttons: pick up the putter and the display comes on; set it
down and it sleeps. Charging is via the exposed USB-C port.

---

## 10. Validation

### 10.1 Sequencing

Validation escalates in cost, and each tier gates the next. No money is spent on an external
reference until the free tiers pass.

| Tier | Cost | Tests | Gate to proceed |
|---|---|---|---|
| 0. Rotary jig | ~$0 | Static angular accuracy | Within ±0.5° at 0, ±1, ±2, ±5° |
| 1. Pendulum | $0 | Dynamic gyro integration | Within ±1° of energy-conservation prediction |
| 2. Phone at 240 fps | $0 | Face angle at impact | Within ±1–2° of video measurement |
| 3. Optical motion capture | $0–250 | Full independent reference | Study targets in §3 |

The rotary jig is a printed indexed protractor plate that clamps the device at known angles.
If Tier 0 fails, nothing downstream matters.

### 10.2 Reference system

**Preferred: optical motion capture via the Sac State Kinesiology department.** Vicon- or
Qualisys-class systems provide sub-millimeter ground truth, exceed the accuracy of any
commercial putting analyzer, cost nothing, and carry the possibility of faculty involvement or
research credit. This is pursued first.

**Fallback: SAM PuttLab.** Ultrasound triangulation, measuring the same kinematic parameters
via an independent physical mechanism. Approximately $100–250 for a fitting session.

**Excluded: Blast Motion and Capto.** Both are grip- or shaft-mounted IMUs. Shared technology
means correlated errors, making them a peer comparison rather than a reference.

**Excluded as primary: Quintic Ball Roll.** High-speed camera focused on ball behavior — roll,
skid, spin. Valuable as a secondary outcome check on whether reported face angle predicts
start line, but not a like-for-like kinematic reference.

### 10.3 Study design

- **3 putters × 30 strokes = 90 paired measurements.** Blade, mallet and zero-torque.
- **Synchronization by sequence, not clock.** One stroke at a time, logged in order on both
  systems, matched by index.
- **Test–retest block:** the puck is removed and remounted between blocks on at least one
  putter, to separate mounting error from algorithm error.

### 10.4 Statistics

Agreement is reported as **Bland–Altman limits of agreement** — mean difference ± 1.96 SD of
the differences — not as correlation. Two instruments can correlate at 0.98 and still disagree
by 3°; correlation measures whether they move together, agreement measures whether they report
the same value. Results are broken out per putter type to test whether the geometry
assumptions generalize.

### 10.5 Logistics

Two constraints that invalidate a session if unplanned:

1. **Bases must be pre-installed in putters the study controls.** A fitter's demo putters
   cannot be modified. The three study putters are owned or borrowed, with bases fitted and
   clocked in advance.
2. **Per-stroke data export must be confirmed before booking.** A summary report without
   per-stroke values is unusable for method comparison.

---

## 11. Data logging

A LittleFS partition occupies the ~13 MB of flash not used by the application.

One stroke at 896.8 Hz × 1.5 s × 6 axes × 2 bytes ≈ **16 KB** (1,345 samples × 12 bytes),
giving capacity for roughly **800 raw strokes** on-device.

*Amended 2026-09-22.* This previously read 500 Hz, ≈9 KB and roughly 1,400 strokes. The
stroke rate was raised to 896.8 Hz in §6.4 on 2026-09-21 and this estimate was not carried
along with it. Recomputed at the new rate: 13,000,000 B ÷ 16,142 B ≈ 805 strokes, before
record headers and filesystem overhead.

Each record carries a header — timestamp, putter profile ID, firmware version, active
calibration values — followed by raw int16 samples. Raw samples are stored rather than derived
metrics, so the corpus remains usable when the algorithm changes.

The corpus is dumped over USB and is the input to the Python development workflow in §7.6.

*Amended 2026-09-29 (Will's decisions).* Two changes, and the format they lead to is in
`2026-09-29-stroke-logging-design.md`.

- **Record sessions, not strokes.** The golfer starts and stops recording, and everything in
  between is kept. A per-stroke record needs something on the device to decide what a stroke
  is, and in Phase 2 that would be the placeholder thresholds that §7.1 and invariant 5 say
  must come *from* this corpus. Selecting the corpus with them would bias it towards what they
  already accept. Strokes are cut out offline. Per-stroke records remain the right thing for
  the finished product.
- **A raw partition, not LittleFS.** On the ESP32-S3 a flash write or erase disables the
  cache on both cores, and the IMU is read directly with no FIFO, so a stall longer than one
  sample period (~1.1 ms) loses samples. LittleFS erases on its own schedule during writes. An
  append-only log erases only when told to (after a dump, at rest), and while recording only
  programs one 256-byte page at a time. Wear levelling buys nothing at tens of cycles.

Samples are stored **losslessly compressed** (per-axis differences, Rice-coded in 64-sample
blocks). Every metric reads both sensors, so no channel can be dropped. Measured on the
simulator at the board's noise floor, 2.3× on a noisy stroke. The partition is the 14.5 MB
after a 2 MB app: about 22 minutes raw, roughly 50 at that ratio, before the board says what
real room vibration does to it. A gap in the sensor's own sample index is recorded exactly,
whatever caused it. That supersedes the per-stroke estimate above.

---

## 12. Risks

| Risk | Impact | Mitigation |
|---|---|---|
| Mount compliance corrupts angular measurement | Project fails its accuracy target | Tap test in Phase 1 (§5.5); escalate to shaft-bore collet |
| Grip butt caps sealed or non-round | Base does not fit study putters | Compatibility survey before base geometry is frozen (§5.6) |
| Accelerometer correction drags attitude during stroke | Systematic face-angle error | Correction gain near zero during stroke window (§7.2) |
| I²C bus contention at 896.8 Hz | Sampling jitter, or a lost sample | Direct polling, touch and display suspended (§6.4) |
| Path accuracy unattainable via double integration | One of three metrics unreliable | Direction classification is the primary output; arc magnitude secondary (§7.4) |
| Motion capture access not granted | No gold-standard reference | SAM PuttLab fallback (§10.2) |
| Reverse battery polarity | Board destroyed | Meter before first connection (§4.4) |

---

## 13. Milestones

Timeline is set against the Fall 2026 semester, which ends 11 December 2026. A Spring 2027
semester abroad is a hard deadline for physical work on this project, so the validation study
must complete before the end of Fall.

| Phase | Deliverable | Target |
|---|---|---|
| 0. Bring-up | Board powers from battery, display renders, IMU streams, charging verified | Week 1–2 |
| 1. Mount | Base and puck printed, grip survey complete, **tap test passed** | Week 2–4 |
| 2. Logging | Raw IMU to LittleFS, USB dump, first stroke corpus collected | Week 4–6 |
| 3. Tempo | Full state machine, tempo reported on-device | Week 6–7 |
| 4. Face angle | Fusion in Python, ported to C, Tier 0–2 validation passed | Week 7–11 |
| 5. Path + UI | Lever arm, path classification, finished LVGL interface | Week 11–13 |
| 6. Study | Motion capture session, Bland–Altman analysis, written report | Week 13–15 |

Phase 1 carries a hard gate. If the tap test fails, the escalation path in §5.5 is taken
before any further firmware work, because every downstream accuracy number depends on it.

---

## 14. Development environment

### 14.1 Flashing

The USB-C port is wired to a **CH343P USB-to-UART bridge** on GPIO43 (TX) / GPIO44 (RX). It is
not connected to the ESP32-S3's native USB peripheral. The board carries BOOT (GPIO0) and
RESET buttons and an automatic download circuit, so `esptool` enters download mode via RTS/DTR
without manual intervention. Manual fallback: hold BOOT, press RESET, release BOOT.

```
idf.py set-target esp32s3
idf.py build
idf.py -p <port> -b 921600 flash monitor
```

The CH343P supports 300 bps–2 Mbps. 921600 is used; 2000000 is the ceiling.

Driver: Windows and macOS require the WCH CH343SER virtual COM port driver. Recent Linux
kernels enumerate the device as CDC-ACM with no driver installation.

### 14.2 Configuration traps

Three settings will produce confusing failures if set wrong, and are recorded here because
each costs an afternoon to diagnose:

1. **PSRAM mode must be QSPI, not OPI.** This board carries the ESP32-S3**R2** with 2 MB
   quad-SPI PSRAM. Selecting octal PSRAM produces boot failures or crashes.
2. **Arduino IDE only — "USB CDC On Boot" must be Disabled.** Serial output is routed through
   the CH343P UART, not native USB CDC. Leaving CDC on boot enabled sends `Serial` output to
   an unconnected native USB peripheral and the monitor stays blank.
3. **Flash size must be set to 16 MB** or the LittleFS partition in §11 will not fit.

### 14.3 No JTAG

The ESP32-S3's native USB pins (GPIO19/GPIO20) are not routed to the Type-C connector, and the
SH1.0 expansion header exposes GPIO15/16/17/18/21/33 only. USB-Serial-JTAG is therefore
unavailable without hand-wiring, and interactive source-level debugging is out of scope.

On-device debugging is limited to serial logging plus panic backtraces decoded by
`idf.py monitor`. This constraint reinforces the development workflow in §7.6: numerical
methods are developed and debugged in Python against the logged corpus, where a debugger
exists, and only settled algorithms are ported to C.

### 14.4 OTA is explicitly not implemented

Over-the-air update is technically available — the SoC has Wi-Fi and ESP-IDF supports OTA —
and is deliberately rejected:

- The magnetic mount (§5.1) already reduces a reflash to pulling the puck off the base,
  plugging into the exposed USB-C port, and reseating. Roughly twenty seconds. OTA would be
  infrastructure built for a problem the mechanical design already solved.
- OTA requires dual application partitions, roughly doubling the application's flash footprint
  at the expense of the stroke corpus in §11.
- Enabling the Wi-Fi stack costs approximately 50–60 KB of internal SRAM, which is contended
  with the LVGL draw buffers in §6.3.
- **The decisive reason:** the Wi-Fi stack changes the interrupt landscape and therefore the
  sampling jitter that the entire accuracy argument rests on. A device validated with Wi-Fi
  compiled out must ship with Wi-Fi compiled out, or the study does not describe the shipped
  firmware.

Wi-Fi remains disabled in all builds. There is one firmware configuration, and it is the one
that gets validated.

---

## 15. Repository structure

```
/firmware        ESP-IDF project
/analysis        Jupyter notebooks, algorithm development
/data            Logged stroke corpus
/hardware        Printed base and puck models, calibration jig, tap-test fixture
/docs            This spec, validation report, accuracy study
```

The accuracy study and the stroke corpus are deliverables of equal standing with the firmware.
