willbpeters/plumb/firmware/main/stroke_config.h

/* The stroke pipeline's device configuration. PLACEHOLDERS: see the .c. */
#ifndef STROKE_CONFIG_H
#define STROKE_CONFIG_H

#include "plumb/pipeline.h"

void stroke_config_fill(pl_pipeline_config *cfg, double sample_rate_hz);

#endif /* STROKE_CONFIG_H */
