willbpeters/plumb/(commit log)

2026-09-15 Add design spec for grip-mounted putting stroke analyzer
    Covers hardware selection, two-part mechanical mount, dual-core firmware
    architecture, sensor-fusion pipeline, three-tier calibration model, and a
    staged validation plan with Bland-Altman method comparison.
    Claude-Session: https://claude.ai/code/session_01AYbjT36zjcKiQphpXYbtau
2026-09-18 Add handoff briefing and CLAUDE.md project context
    CLAUDE.md records the eight hard invariants that fail silently, the stack,
    layout and conventions. HANDOFF.md states current project status, the one
    unblocked critical-path task (synthetic stroke harness) with its definition
    of done, what is blocked on hardware, and open questions for the owner.
    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
2026-09-21 Add Arduino bring-up smoke test
    Throwaway sketch confirming the toolchain before any real firmware exists:
    serial over the CH343 UART bridge, I2C bus on GPIO6/7, and the QMI8658
    WHO_AM_I register.
    Verified on hardware: ESP32-S3 rev2, 16 MB flash, 2 MB QSPI PSRAM,
    IMU responding at 0x6B with WHO_AM_I=0x05. Clears the three configuration
    traps in spec 14.2.
    The CST816S touch controller did not answer the I2C scan; likely held in
    reset. Not on the critical path (spec 6.2 polls touch only outside the
    stroke window).
    [smoke_test.ino]
2026-09-21 Add design spec for synthetic stroke harness
    Design for Task 1: validate the section 7 fusion pipeline with zero hardware
    by forward-modeling the sensor and recovering a face angle we specified
    ourselves.
    Three decisions carry the design:
    - The pipeline under test is streaming and C-shaped, not vectorized, so
    lookahead the firmware cannot have is structurally impossible.
    - The forward model emits raw int16 counts rather than floats, so
    quantization cannot be silently bypassed.
    - The generator models three rotational DOF including lie angle, so the
    ground-plane projection in section 7.3 is actually exercised rather than
    degenerating to a no-op.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
2026-09-21 Add implementation plan for synthetic stroke harness
    Eleven TDD tasks from project scaffold through the parameter sweep.
    Working the math through surfaced a refinement to the harness spec: face
    angle as the device reports it (ground-plane azimuth, relative to address)
    is not the same as shaft rotation when the shaft has lie angle. The two
    differ by atan(tan(phi)cos(lie)) vs phi -- 0.12 degrees at a 20 degree lie
    and a 2 degree face, which exceeds the 0.1 degree tolerance the noiseless
    test asserts. The generator is therefore parameterized by the reportable
    quantity and solves for shaft rotation internally.
2026-09-21 Add quaternion primitives with explicit Hamilton convention
    Implements identity, from_axis_angle, multiply, conjugate, normalize,
    rotate, integrate, twist_angle, to_matrix and from_matrix per the
    task-2 spec. Omits the rot_x/rot_y/rot_z helpers present in the
    provided reference implementation, since they are unused by any test
    and the task explicitly disallows adding functions beyond those
    listed ("no Euler-angle helpers"). Adds one extra test exercising the
    untested trace<=0 branch of from_matrix (180-degree rotation about X),
    as invited by the task description.
2026-09-21 Record twist-vs-azimuth residual in harness plan
    Verified the plan's derivations numerically against plumb.quat before the
    trajectory generator depends on them: the analytic angular velocity matches
    numerical differentiation to 4e-6 rad/s, and the projection identity is exact.
    The twist about measured gravity and the ground-plane azimuth of the face
    normal differ by ~1.3e-3 degrees at a 5 degree face angle. Documented so the
    residual is not mistaken for a bug and chased.
2026-09-21 Fix sampling-grid defect in harness plan trajectory generator
    Phase boundaries were computed as floats, so a tempo ratio like 1.5 put
    impact at sample 233.33 rather than on a whole sample. Theta was then only
    near zero at impact, the arc_gain*theta term in the face rotation failed to
    vanish, and ground-truth face angle drifted about 0.02 degrees with the
    drift scaling in arc_gain.
    That is the shape of an invariant 1 violation -- accuracy varying with
    putter type -- while actually being a sampling artifact of the generator.
    It would have been found by a test that the plan forbids fixing, since
    loosening the tolerance is the wrong response.
    Boundaries now snap to whole samples and every dura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
2026-09-21 Switch pipeline to trapezoidal integration and fix omega test method
    Two findings from measuring the plan against the real 500 Hz grid before the
    pipeline was written.
    Rectangle-rule gyro integration costs 0.0553 deg of recovered face angle over
    45 noiseless strokes -- 55 percent of the 0.1 deg noiseless budget, spent
    before noise, bias or quantization exist. Trapezoidal integration costs
    0.0013 deg, a 41x improvement for one add and one multiply. Averaging the
    rate across the interval needs the sample at its end, which is one sample of
    latency rather than lookahead, so it remains implementable on-device.
    The angular-velocity test differenced attitude forward, which estimates the
    average r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
2026-09-21 Add ground-truth stroke trajectory generator
2026-09-21 Fix int16 overflow in saturation test and document pivot vector direction
    The impact-saturation test took np.abs of int16 counts. abs(int16(-32768))
    overflows back to -32768, so the check silently read the wrong value at
    exactly the rail it existed to detect, and would have failed against a
    correct forward model. Now casts to int32 and accepts either rail.
    Also documented why the pivot vector d points along negative body Z: it runs
    from the pivot to the sensor, as the parent spec formula assumes, and the
    pivot sits above the grip butt. Verified by checking that omega x (omega x d)
    comes out centripetal.
2026-09-21 Add QMI8658 sensor forward model emitting int16 counts
2026-09-21 Keep every plan task green and align g0 capture with the stillness window
    Task 5 told the implementer to commit with a deliberately failing test as
    the next task's entry point. A red suite at a commit boundary makes a
    known-incomplete feature indistinguishable from a regression, and an
    implementer following the project's own verification standard will refuse to
    commit -- which is the correct instinct and would have stalled the task. The
    full state-machine assertion moves to Task 6, where the states it asserts
    actually exist.
    Also: g0 was averaged over every idle sample while the gyro bias was averaged
    over the stillness window. Parent spec 7.1 captures both on entering ADDRESS,
    and averagin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
2026-09-21 Add pipeline address detection and per-stroke gyro bias nulling
2026-09-21 Back-track stroke boundaries so tempo meets its spec target
    Threshold-crossing segmentation misses the parent spec section 3 tempo
    target by seven times. Measured on the noiseless generator, worst absolute
    error 0.351 against a 0.05 target, systematically biased low and worsening
    as tempo ratio rises: 0.132 at 1.5:1, 0.351 at 3:1.
    The cause is asymmetric detection latency. Backswing start fires only after
    the rate climbs to 8 deg/s and then persists for 40 ms, roughly 54 samples
    late, while impact is detected within one sample. That does not cancel in a
    ratio.
    Both boundaries are now back-tracked to where they actually occurred: the
    last quiet sample before the backswing, and the last samp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
2026-09-21 Add stroke segmentation, attitude integration and tempo ratio
    Extends the pipeline through DOWNSWING, IMPACT, FOLLOWTHROUGH and DONE,
    adding back-tracked boundary detection (backswing onset and the
    backswing/downswing direction reversal), trapezoidal-integrated
    attitude with state-driven accelerometer gain, and tempo ratio
    computation.
    Also narrows test_backswing_is_detected to check the visited prefix
    rather than terminal state: BACKSWING was terminal before this task's
    stub, and is now a mid-sequence state confirmed in full by the new
    test_state_machine_visits_every_state_in_order.
2026-09-21 Take impact instant at the middle of the acceleration spike
    The impact threshold fires on the spike's rising edge, one or more samples
    before the strike. Sampling attitude there carries residual pre-impact
    rotation into the twist about gravity, and because that leak couples through
    the shaft axis it scales with how fast the face was rotating: 0.037 deg of
    error for a straight stroke against 0.072 deg for an arced one.
    Accuracy that tracks arc type is a putter-type prior, which invariant 1
    prohibits. It passed the 0.1 deg tolerance, so a looser test would have hidden
    it, and it would grow on faster real strokes.
    The peak cannot be used because the spike saturates by design, so several
    sampl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
2026-09-21 Correct half-sample bias in the transition instant
    Moving the impact instant to the true strike exposed an off-by-one on the
    other boundary, and the suite went red at tempo 3:1 (error 0.059 against a
    0.05 target).
    The rate crosses zero BETWEEN the last same-sign sample and the next one, so
    the last same-sign sample is the near edge of the bracket rather than the
    crossing. Taking it directly biases the transition half a sample early. That
    half sample enters the tempo ratio twice with the same sign, because the
    backswing and downswing sit on opposite sides of it: one is lengthened and
    the other shortened.
    Worst error falls from 0.059 to 0.043, inside the target, with no threshold
    touched. Dr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
2026-09-21 Add stroke path, gate accel correction on measured stillness
    Three defects, all found because a straight stroke with zero face angle must
    produce zero lateral displacement for a geometric reason, and produced 25 mm.
    1. Accelerometer correction ran during the backswing-confirmation lag.
    BACKSWING is not confirmed until roughly 53 samples after motion begins, so
    the machine still read ADDRESS while the stroke was underway and corrected
    attitude against an accelerometer that was no longer reading pure gravity.
    That is exactly the failure invariant 2 describes, and the injected error
    was then frozen in because the gain is zero for the rest of the stroke.
    Every face-angle test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
2026-09-21 Make stroke onset independent of face rotation and of the threshold
    Two related defects in onset detection, found by a test asserting that
    segmentation is bit-identical across putter types.
    1. The onset gate used the full three-axis rate magnitude. Face rotation is
    rotation ABOUT the shaft axis, so that mixes it into the swing measurement
    and the threshold fires earlier for a putter whose face turns more. Measured
    as a one-sample shift in the recorded stroke start between an arced and a
    zero-torque putter that were identical in every other respect. That is
    segmentation keying off rotation amplitude, which invariant 1 prohibits --
    small, but structural, and it is the exact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
2026-09-21 Add parameter sweep and noise degradation reporting
    Sweeps face angle, arc type, tempo, gyro noise and gyro bias, and reports the
    two numbers the definition of done asks for: worst recovery error, and the
    noise level at which the parent spec section 3 face-angle target stops being
    met.
    Detection failure is recorded as data rather than discarded. Above roughly
    0.5 dps of gyro noise the stillness threshold sits under the noise floor,
    ADDRESS never triggers and no stroke is reported at all. That is a real
    failure mode with its own target in section 3, and treating it as a missing
    value would average it away.
    Tests run a reduced grid; the full grid runs from one command via main(),
    because 150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
2026-09-21 Document synthetic harness usage and measured sweep results
    Records the measured numbers rather than claimed ones: 2835 strokes, worst
    face-angle error 0.0809 deg against a 1.0 deg target, and graceful monotonic
    degradation across four decades of gyro noise.
    States plainly what the harness proves and what it does not. It proves the
    fusion math, since ground truth is known by construction. It says nothing
    about sensor behaviour or mount rigidity, which are measured on hardware.
    Also records the two limits worth knowing before the board arrives: detection
    fails above roughly 0.5 dps of gyro noise while accuracy is still degrading
    gracefully, so detection is the binding constraint rather than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
2026-09-21 Add design spec for IMU streaming instrument
    Turns the board into a measuring instrument: QMI8658 configuration, FIFO
    drain on interrupt, raw int16 over serial in either CSV or framed binary.
    Three decisions carry the design.
    Per-sample MCU timestamps are deliberately absent. Sample spacing comes from
    the sensor's oscillator, not from when the MCU drains the FIFO, so timestamping
    on arrival would record read latency and label it jitter. What firmware can
    actually get wrong is losing samples, since a FIFO overflow breaks the time
    base silently, so the instrument reports a sample counter, the overflow flag
    and a measured ODR instead.
    Both wire formats are supported because the tap test forc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
2026-09-21 Add implementation plan for the IMU streaming instrument
    Ten tasks. Six are buildable without hardware and four are on-device
    measurements with recorded numbers.
    Verification differs from the harness plan because this is firmware. The host
    decoder is test-driven against hand-written golden vectors; the firmware is
    compile-checked and then verified by the section 9 acceptance runs. The binary
    encoder is deliberately not unit-tested -- that would need a native build with
    a stubbed Wire, which is real infrastructure for throwaway bring-up code -- so
    the format is pinned by vectors the decoder is tested against, and an encoder
    mismatch surfaces on the first capture as a sync or checksum failure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
2026-09-21 Add host decoder for the IMU wire format
2026-09-21 Add QMI8658 driver with configuration read-back
    Register map, ODR table and FIFO/CTRL9 protocol cross-checked against the
    QST QMI8658C datasheet (Rev A and Rev 0.9) and lewisxhe/SensorLib. No
    plausible-looking constants: every config write goes through writeVerified,
    and CTRL9 commands (FIFO reset/read-mode entry) go through the documented
    STATUSINT handshake instead, since a read-back check on CTRL9 would pass
    trivially without proving the command executed.
    Gyro full scale is set to +-256 dps, the nearest of the part's actual
    doubling-step options (16/32/.../1024 dps) to the requested +-250 dps --
    this part has no +-250 dps setting, confirmed by two independent sources.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
    [imu_stream.ino, qmi8658.cpp, qmi8658.h]
2026-09-21 Amend gyro full scale to plus-minus 256 dps, the value the part actually has
    Spec section 6.4 specified a gyro range the QMI8658 cannot produce. Its
    full-scale table is powers of two -- 16, 32, 64, 128, 256, 512, 1024, 2048 dps
    -- and plus-minus 250 is an InvenSense convention carried across in error.
    Confirmed against the QST datasheet rev 0.9 and rev A and an independent
    driver implementation.
    This was quietly dangerous rather than cosmetic. Configuring the part at 256
    while converting counts at 250 makes every recovered rate 2.4 percent low: a
    systematic scale error in every integrated angle, undetectable without an
    external reference, and exactly the class of silent failure this project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
2026-09-21 Add CSV and binary output framing
    Named framing.h/framing.cpp rather than stream.h/stream.cpp as specified:
    on this Windows checkout the filesystem is case-insensitive, and the ESP32
    Arduino core ships its own cores/esp32/Stream.h (the Stream base class used
    throughout Arduino.h -> Udp.h). A sketch-local stream.h collides with it,
    so Arduino.h's own #include <Stream.h> resolves to our file instead of the
    core's, producing redefinition errors for Rate/Sample/DrainResult/Format.
    Renaming avoids the collision; contents are otherwise exactly as specified.
    [framing.cpp, framing.h]
2026-09-21 Add IMU streaming sketch with serial control
2026-09-21 Add bring-up results skeleton and rename stream to framing in docs
    The output-framing files could not be called stream.h and stream.cpp. The
    sketch directory sits on the include path so that qmi8658.h can find its
    neighbours, and Windows has a case-insensitive filesystem, so a local stream.h
    shadows the ESP32 core's Stream.h -- the base class behind Serial and Wire.
    Arduino.h pulls it in through Udp.h, resolved to our file instead, and
    redefined every type in it. Renamed to framing.h and framing.cpp, and the spec
    and plan updated to match.
    Also adds docs/bringup-results.md, where the five on-device acceptance
    measurements get written down. It is a skeleton with the procedures, the
    compariso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
2026-09-21 Set stroke rate to 896.8 Hz and fix a rate-dependent correction gain
    Spec section 6.4 specified 500 Hz for the stroke and 100 Hz for monitoring.
    Neither exists on the QMI8658, whose ODR steps derive from the gyro's natural
    frequency rather than round numbers. Amended to 896.8 Hz and 112.1 Hz.
    896.8 was taken rather than the nearer 448.4 on measured evidence: the harness
    found tempo ratio to be the binding accuracy constraint and tempo error scales
    with sample resolution. Noiseless tempo error halved, 0.0170 to 0.0090.
    Current draw is NOT measured -- this board has battery voltage sense but no
    current sense -- and the spec amendment says so. It is bounded by duty cycle,
    since the device slee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
    [qmi8658.cpp]
2026-09-21 Fix per-sample FIFO reads and record first on-hardware measurements
    First data off the real board, and it found two defects.
    Fixed: drain() issued a complete I2C transaction per 12-byte sample, so a
    64-sample drain cost 64 transactions where parent spec 6.4 mandates batching
    to avoid exactly that. Chunked burst reads of 120 bytes turn 64 transactions
    into 7, and delivered rate went from 652.68 to 709.91 Hz.
    Open: FIFO_OVFLOW is set on 224 of 225 consecutive drains and roughly 20
    percent of samples are lost. The driver reads the datasheet as saying the FIFO
    does not accept samples while the part is in read mode, and if that is right
    the loss is bounded by I2C bus time: 17.3 ms of bus per 64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
    [capture.py, qmi8658.cpp]
2026-09-21 Read the datasheet: confirm read-mode loss, enable the LPFs, find a FIFO read defect
    Datasheet obtained (QMI8658C rev 0.9) and read. Four things settled.
    FIFO_CTRL bit 7 states outright that the bit must be cleared after a read so
    that writing to the FIFO can resume, confirming that time in read mode is time
    the sensor is not storing samples. The 19.5 percent prediction was built on
    that model and matched the measured 20.8, so the model is right.
    I2C is capped at 400 kHz, so the loss cannot be bought back with bus speed.
    That undermines parent spec 6.4's justification for FIFO batching, which
    claims an order-of-magnitude reduction in bus cost. Batching reduces
    transaction overhead, not dat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
2026-09-21 Add deferred distance approximation and promote impact speed to a first-build metric
    Distance estimation from a pre-round pace calibration is wanted but deferred,
    and recorded as deferred rather than as a non-goal so the distinction from
    section 1.2 stays clear.
    The measurement half is nearly free: clubhead speed at impact falls out of
    v = omega x r, the same relation section 7.4 already uses for path. Impact
    speed is therefore a first-build metric, not a deferred one.
    Mapping speed to distance is the deferred part, and it is a different kind of
    problem from the rest of this spec. Face angle and tempo are properties of the
    putter that a rigid-body argument makes exactly recoverable. Distan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
2026-09-22 Add the missing ground-truth path test and record a known shortfall
    Every path test in the suite checked the pipeline against itself -- straight
    shaft gives a straight line, arc grows with lie angle, arc ignores putter
    type -- and all of them passed with a 39 percent error present. The
    generator's true face trajectory was available the whole time and unused.
    Compared against it, the pipeline's arc magnitude is about 61 percent of
    truth, against the 10 percent target in parent spec section 3. This metric
    does not meet spec.
    Cause: face velocity is computed as omega x r, which assumes the sensor does
    not translate. It does. The putter pivots near the hands, roughly 0.55 m above
    the grip butt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
2026-09-22 Bring the handoff current
    The handoff still said hardware was in transit and nothing was built. It was
    written on 2026-09-18, before the synthetic harness, the streaming
    instrument, three spec amendments and two days of hardware findings.
    Now records what is built and proven, the two open FIFO defects that block
    every hardware measurement, the known path-magnitude gap, the spec amendments
    and why each was made, the product decisions taken with Will, the reduced
    validation scope, and what remains blocked on him.
    Names the next task explicitly: the direct-register read path, with the
    criterion that makes its result decisive either way.
    CLAUDE.md's 'do not write firmware that assumes hardwar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
2026-09-22 Bypass the FIFO: the direct read path loses nothing, and measures its own rate
    The experiment the handoff called for, and it was decisive. Both read paths on
    the same board, same surface, 60 s each, back to back:
    direct fifo
    sensor ODR 906.86 Hz frozen counter, unmeasurable
    delivered 906.86 Hz 707.80 Hz
    samples lost 0% 21.9%
    overflow flag never 665 of 665 batches
    resting sigma, worst 0.2765 dps 0.3405, varying with batch position
    So three acceptance criteria are now met rather than blocked. 9.2 zero dropped
    samples over 60 s, 9.3 the real ODR, and 9.4 the resting gyro noise floor --
    0.2765 d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
    [capture.py, framing.cpp, framing.h, imu_stream.ino, qmi8658.cpp, qmi8658.h, rest_noise.py]
2026-09-22 Add the axis and sign check, and split the noise floor from the room
    The tool for 9.1: rest the board on a face, turn it a quarter turn
    anticlockwise, and it decides. Gravity supplies the reference, so it needs no
    printer, no putter and no protractor -- a sensor at rest reads +1 g on whatever
    axis points up, and by the right-hand rule an anticlockwise turn about that up
    direction must read positive on the matching gyro channel. Three faces covers
    the triad. What it catches is a left-handed triad, which is the kind of defect
    that reports a stroke that opened as one that closed.
    It removes the gyro bias before integrating -- 2.9 dps over a two-second window
    is six degrees of pure error on a c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
    [axis_check.py, board.py, capture.py]
2026-09-22 Estimate the pivot offset, closing the 61% path shortfall
    The pipeline computed face velocity as `omega x r`, which assumes the sensor
    does not translate. It does: the putter swings about the hands, so the face
    travels on `r + d` -- 1.4 m against the 0.85 m assumed, and 0.85/1.4 = 0.607,
    which is exactly the shortfall that was measured and pinned. The diagnosis was
    already written down. What was missing was a way to measure d.
    The earlier attempt estimated it per sample and was abandoned because
    differentiating the gyro amplifies noise by 1/dt and the estimate collapses
    around this sensor's own floor. What changed is the framing, not the sensor:
    a_body = omega_dot x d + omega x (omega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
2026-09-22 Measure the axes and signs: the triad is identity and right-handed
    Spec 9.1, on the board, with Will turning it. Rested on three faces and turned
    a quarter turn anticlockwise about each vertical in turn:
    board axis up gyro responded angle verdict
    +X +X +73.8 deg PASS
    +Y +Y +99.8 deg PASS
    -Z -Z -94.9 deg PASS
    Gyro X is board X, Y is Y, Z is Z, no swap and no sign flip. The port needs no
    remapping at the driver boundary. What it rules out is the defect that would
    have mattered most: a left-handed triad reports a stroke that opened as one
    that closed, and nothing downstream would have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
2026-09-22 Start the C port: quat.c, bit-identical to the Python it came from
    The step that turns a proven algorithm into a device. quat.c first, because
    everything else depends on it and because the risky part was never the
    quaternions -- it was proving that a translation can be checked at all.
    operation double float
    multiply 0.000e+00 1.078e-07
    rotate 0.000e+00 1.644e-07
    integrate 0.000e+00 1.025e-07
    twist_angle 0.000e+00 3.872e-05
    conjugate 0.000e+00
    normalize 0.000e+00
    from_axis_angle 0.000e+00
    to_matrix 0.000e+00
    Worst difference from NumPy over 400 random cases per operation, re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
2026-09-22 Build the port test without a shell, after it silently verified nothing
    Will ran the differential test from PowerShell and got ten skips. The fixture
    shelled out to firmware/test/build.sh, which needs `sh` on PATH -- present in
    Git Bash, where I had run it, and absent in PowerShell. So it skipped every
    case, printed `ssssssssss`, and read as a pass.
    That is the exact failure this project keeps finding: a check that looks like
    it ran and did nothing. It is the same shape as "dropped: 0" sitting next to
    20% sample loss, and it was in the tooling built to stop translation errors
    reaching a board with no JTAG.
    The build now lives in analysis/tools/cbuild.py and invokes the compiler
    directly, s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
    [cbuild.py]
2026-09-22 Re-measure defect 4: it is mostly the pivot estimate, not the statistic
    The handoff sent me to replace ptp(lateral), on the diagnosis that peak-to-peak
    of an integrated signal collects the extremes of the random walk. Measured, that
    is the smaller half. Substituting the TRUE pivot offset into the same noisy
    stroke splits it, at a 5 deg lie and 0.28 dps:
    truth 1.000
    pipeline, zero noise 1.051 pivot filter bias
    noisy samples, TRUE pivot substituted 1.096 <- this IS defect 4
    noisy samples, estimated pivot 1.244 <- what we report
    So ~60% belongs to the pivot estimate and no statistic reaches it. The smooth
    fi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
    [cbuild.py]
2026-09-22 Hardware purchasing spec, and the battery is blocked on a live hazard
    Parent spec 4.4 hazard 4 says to read the charge current off the Waveshare
    schematic and confirm it is <=1C for the fitted cell. Nobody had. Done now:
    charger ETA6098, not the ETA6096 the BOM names
    R15 160K fitted, on ISET
    table the schematic's own: 160K -> 1A, 82K -> 2A, 66K -> 2.5A
    Cross-checked against the ETA6098 datasheet, which characterises 82K -> 2A and
    150K -> 1.2A. Waveshare's 82K row matches exactly, so the board charges at
    roughly 1 A.
    The BOM's 400 mAh cell at 1 A is 2.5C, against the spec's own <=1C rule. Meeting
    1C needs >=1000 mAh, and a 1000 mAh pouch does not fit: a 37.50 mm PCB ci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
2026-09-22 Competitive feature review against Plus Putt Path, and five amendments
    Plus Putt Path is the closest existing product -- grip-mounted, round display,
    reports on-device with no phone -- so its feature list is a useful mirror.
    Graded every item against what a 6-axis IMU at the butt can actually recover.
    The most valuable finding is not a feature. They list SuperStroke Tech Port
    compatibility: a manufacturer-designed sensor port in the grip butt. That is a
    third mount option sitting between 5.1's barbed taper and 5.5's destructive
    step-drill-and-collet escalation. Its real value is as a KNOWN-GOOD REFERENCE
    for the tap test -- run 5.5 against both and the highest-risk unknown in the
    project st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
2026-09-22 Decision register for the metrics the pipeline computes and discards
    Will asked for the unused metrics written up somewhere reviewable, so the v1/v2
    call can be made later rather than now. Section 4a of the feature review, with
    an empty "your call" column.
    Grounded in pipeline.py rather than in the previous section's prose, and that
    turned up a gap that is not a v1/v2 question at all: 1.2.1 says in bold that
    impact speed "is not deferred -- it is a first-build metric", on the grounds it
    falls out of the v = omega x r that 7.4 computes anyway. It is not implemented.
    grep for "speed" over pipeline.py and trajectory.py returns nothing, and
    v_face is built every sample and dropped. That is a de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
2026-09-23 Take the address reference from the stillness before takeaway, and let strokes end
    A review found three state-machine defects that every existing test passed,
    because every synthetic stroke began with exactly one second of perfect
    stillness and ended in an impact. Each now has a failing-first test that
    compares against the generator's ground truth.
    1. Re-aiming the face after settling was reported as face angle. g0 and the
    bias were captured once, at first stillness, and everything after was
    integrated. A 2 deg re-aim read 1.88 deg on a square stroke. The reference
    now comes from the latest still window ending at or before the
    back-extrapolated onset; attitude is identity there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
    [imu_stream.ino, qmi8658.h]
2026-09-25 Fix the sign of the accelerometer correction, which was positive feedback
    The complementary correction used predicted x measured. q maps body to
    reference and integrate() applies a body-frame rate, under which a fixed
    reference vector seen from the body moves as dp/dt = p x w; with
    w = m x p, p turns toward m. The reversed product turned it away.
    The stock gain hid it: q resets to identity on ADDRESS entry and the gain
    is a ~50 s time constant, so a 2 deg tilt only reached 2.082 deg over 2 s.
    At a gain of 2.0 it reached 87 deg. The new test seeds a known tilt against
    known gravity and requires it to decay, which is ground truth, not the code
    checked against itself.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
2026-09-25 Forbid FMA contraction in the port, on host and device
    The bit-for-bit comparison against NumPy means nothing if the compiler may
    fuse a*b+c into one rounding. x86-64 baseline happens not to; the
    ESP32-S3's GCC does by default (the LX7 has MADD.S), so the device would
    have diverged from the build that was diffed. -ffp-contract=off in both
    cbuild.py and the component's CMakeLists, and /fp:precise stated for MSVC.
2026-09-25 Carry the 896.8 Hz rate through the docs, and say what the harness proves
    Stale 500 Hz figures in the spec's power budget, ADDRESS entry and the
    trajectory docstring; the imu_stream comment quoted pre-correction noise
    and loss numbers. The README and handoff now state that the synthetic
    face-angle figures show agreement with the generator's model, and list the
    assumptions the generator and pipeline share, which no synthetic test can
    catch.
    [imu_stream.ino]
2026-09-25 Time the transition off the swing, not off whichever axis is largest
    The transition was the sign flip of the largest body axis at backswing
    entry. That included body Z, the face-rotation axis, and entry happens
    when the swing is barely started (~12.5 dps), so a face opening faster
    than that timed the transition off face rotation: measured as a 100 ms
    shift, all of it into tempo. An invariant-1 violation the existing test
    could not see, because no generated arc type turns the face that fast.
    The "last 25 samples" it averaged also only ever held one.
    Now the swing perpendicular to the shaft, projected on the backswing's own
    direction -- the same principle the onset detector already uses. No
    t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
2026-09-25 Correct the pivot docstring's claim that the fit is exact
    K is built from the filtered rate and its centripetal term is quadratic,
    so K(LPF[w]) is not LPF[K]. Filtering the matrix instead was measured:
    exact noiselessly only if every filter starts from rest, which the
    pipeline cannot do, and no better at the board's 0.28 dps floor. The
    table is in the docstring; the code is unchanged.
    Also two comments that still credited firmware/test/build.sh.
2026-09-25 Measure the arc over the motion, not the stillness around it (defect 4)
    The face track is an integral of a noisy rate, so it wanders whenever it
    is integrated -- including address and the 0.3 s follow-through hold, when
    the real face is not moving. The arc ran to the end of that hold, so wander
    there moved the chord defining "forward" and rotated every lateral value:
    0.3 dps injected into the hold alone moved a 24 mm arc by -12.1%/+12.9%.
    Now 0.000%, with face angle and tempo bit-identical.
    The arc now spans the back-extrapolated onset to the first sample of the
    quiet run that ended the stroke. Whole pipeline, calibrated pivot, 0.28 dps
    + 1.5 dps bias, strokes 5-20, arc / truth:
    straight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
2026-09-25 Measure single precision across a whole stroke: 4.0e-5 deg of face angle
    The per-operation diff showed one ulp per step; the open question was what
    ~1,850 accumulated steps do, each adding 1e-4 rad or less to quaternion
    components where one ulp is 1.2e-7. The harness gains seqreset/seqstep/
    seqtwist, which carry the attitude in pl_real between lines as the device
    will, and the test replays every quat.integrate call the Python pipeline
    makes from ADDRESS entry to impact on simulated strokes.
    Double replay: exactly the pipeline's face angle on all twelve strokes,
    which proves the replay is faithful. Single: at most 4.0e-5 deg against the
    1.0 deg target. A 30 s address hold (53,719 steps) gave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
2026-09-25 Bring the handoff current for 2026-09-25
    Records this session's fixes, the whole-stroke single-precision number,
    and open defect 4 split into its fixed half (track wander) and its open
    half (the pivot fit's weak direction on the arced putter), with the
    before/after table and the untried six-unknown fit.
2026-09-25 Fit the pivot in velocity, corrected for gyro noise: arced putter 1.142 -> 1.010
    The arced putter's arc read 1.142 of truth at lie 5 against 1.010 for a
    straight putter on identical noise. Oracles pinned it: the true angular
    rate in the fit took it to 1.049; the true acceleration changed nothing.
    Errors-in-variables: face rotation tilts the rotation axis ~19 deg off body
    Y, the fit's weakest direction carries a real 0.18 m of d, and noise in the
    design matrix -- a differentiated rate, noise power ~0.006 per sample
    against ~0.006 of signal -- shrank it by half. The fake remainder sat off
    the shaft axis, where face rotation turns it into sideways path.
    Three changes, each measured:
    - Velocity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
2026-09-25 Close open defect 4 in the handoff, and record the accel-bias finding
    Defect 4's second half is fixed by the velocity-form pivot fit; the
    handoff's earlier guess (a tilt leak, to be absorbed by a six-unknown fit)
    is retracted with the oracle that disproved it. New defect 6: accelerometer
    bias inflates the arc (+5% at 0.05 m/s2, +27% at 0.2) by a path that is not
    the pivot and not g0's ground plane. Amendment count in CLAUDE.md and the
    handoff brought to five, for spec 7.4.
2026-09-25 Find how accelerometer bias reaches the arc, and apply the 8.1 calibration
    Open defect 6. Oracles on each use of g0 separately, 0.2 m/s^2 bias, arced,
    lie 5 (no-bias 1.031, biased 1.406):
    - ground plane: true gravity there alone -> 1.203. g0 is gravity plus bias,
    so the projection plane tilts by bias/g and the head's ~3 cm of vertical
    travel leaks into lateral. Per axis, it is body Y -- the swing axis, which
    the stroke cannot observe: 1.296 -> 1.066 with the true plane.
    - pivot fit: g0 cancels the bias only at the address orientation, leaving
    (I - R^T) b. Body X, +8%.
    - face angle: ~0.004 deg. Immune.
    Linear and symmetric at small bias: 1.21% of arc per 0.01 m/s^2 on Y at
    lie 5, 0.4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
    [accel_cal.py]
2026-09-26 Plan the UI screens on the host, against a verified LVGL 9.6 spike
    Eight tasks, 56 steps. Grounded in a scratch spike rather than memory:
    LVGL 9.6 builds with MSVC in ~4 s, renders headlessly, and lv_font_conv
    1.5.3 output compiles and draws the degree sign, middle dot and em dash.
    The spike also found the trap the plan now avoids: 9.6 deprecates
    LV_COLOR_DEPTH, its fallback hits #warning, and MSVC's C compiler treats
    #warning as fatal (C1021).
2026-09-26 Build the headless UI bench: geometry, style, shell, renderer, tests
    Task 3 of docs/superpowers/plans/2026-09-26-ui-screens.md. 37 tests, 3.3 s:
    geometry against hand-derived values, a glyph counter proven able to fail,
    navigation, page dots, the round aperture, and no-reading screens. The four
    screens are stubs until Tasks 4-7.
    Three deviations from the plan, each found by running it:
    - LVGL 9.6 has two vg_lite_matrix.c. The plan's guard refused to build
    rather than let one object overwrite the other; sources are now grouped
    so no group holds two same-named files, each into its own directory.
    - The final cl command had -TC, which means "every input is C" -- and that
    command also take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
    [cbuild.py, geometry.c, geometry.h, screen_face.c, screen_path.c, screen_speed.c, screen_tempo.c, screens.h]
2026-09-26 Draw the face angle screen: 5x rotation measured back from pixels
    Open, closed and the 45 deg clamp are measured from the rendered face edge
    by its principal axis, within 1 deg of 5x the input. One layout change from
    the studies: HEEL moved beside the heel (baseline 147), because at their
    y=163 the 64 px hero number drew over it.
2026-09-26 Draw the path screen: direction and amplified arc checked from pixels
    The word TARGET is left off this screen, keeping the arrow: its target line
    and trail ran straight through it (they do in the studies too). The face
    screen keeps both. UI spec 4.3 corrected to say the path is a straight
    segment, which is what the studies' quadratic actually drew.
    [screen_face.c, screen_path.c, style.c, style.h]
2026-09-27 Bring up the display and touch: plumb_ui screens on the GC9A01 panel
    firmware/bringup-arduino/display, a bring-up instrument beside imu_stream.
    esp_lcd SPI panel I/O with DMA and Espressif's GC9A01 init table (credited),
    two 240x60 partial buffers in internal DMA SRAM (invariant 7), the RGB565
    byte swap in the flush, a CST816 pointer device, and LVGL's gesture event
    mapped to pl_ui_next/prev. plumb_ui and its fonts compile from their one
    location in the repo through one-line wrappers; tools/board_ui.py holds the
    arduino-cli invocation that makes that work.
    Verified with Will at the board: MADCTL 0x48 (MX + BGR; BGR alone mirrored
    every glyph) with inversion on, all four screens match the ho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
    [board_ui.py, cst816s.cpp, cst816s.h, display.ino, gc9a01.c]
2026-09-27 Record the display bring-up, and amend 4.4: the charger is set to 1 A
    bringup-results.md gains the pin map (from the Rev3 schematic, confirmed by
    the panel and touch working on it), the orientation found by eye, the
    measured refresh times, the touch chip ID (0xB5, read by common drivers as
    CST816T, not the documented CST816S) and the swipe log.
    The same schematic shows an ETA6098 with R15 = 160 kOhm, which its own
    table maps to 1 A -- 2.5C on the spec's 400 mAh cell, against 4.4's 1C
    limit. Spec 4.4 amended and the LiPo item in the handoff updated, marked
    as read from the schematic and not yet measured.
2026-09-27 Add the acquisition core: ring, sample accounting, jitter histogram, framing
    Pure C, proven on the host against references that are not itself: NumPy's
    nearest-rank percentile, capture.py's decoder, a generated sequence with known
    gaps across the 24-bit wrap, and a bounded deque. Mutating the percentile
    rounding or one frame byte fails the tests.
    [cbuild.py, frame.c, jitter.c, ring.c]
2026-09-27 Move the panel driver into a board component, keep the sketch on it
    The bring-up sketch compiles the driver from its new home through a wrapper;
    its binary is byte-for-byte the same size (671,312 B) before and after.
2026-09-27 Add the QMI8658 SyncSample driver and the CST816 touch driver on ESP-IDF
2026-09-27 Add the app task: stream, jitter windows, the gate, UI port, console
    [app_main.c, gate.c, gate.h, stream.c, stream.h, uart_io.c, uart_io.h, ui_port.c]
2026-09-27 Enable the QMI8658's INT2 output: rev A calls the bit reserved
    With CTRL1 bits 4:3 clear, as rev A's register table implies, no DRDY edge
    reached GPIO3: reads=0, drdy_timeouts climbing at 10/s. With bit 4 set, reads
    run at the sample rate with zero loss over 2,151 samples.
2026-09-27 Make the IMU come up on every reset: bus recovery and the CTRL9 handshake
    Measured over repeated resets through EN, before: 5 of 20 and 12 of 40
    failed. Two causes, each found with a diagnostic now on the status line:
    - A reset mid-read leaves the IMU holding SDA low. ESP-IDF's own bus clear
    did not free it. A hand recovery that stopped clocking at the first high
    SDA still failed 4 of 40 (a 1 data bit is not a release). Nine clocks
    with SDA released, then a STOP (UM10204 3.1.16), frees it every time.
    - The CTRL9 handshake takes 3253 us, measured, every time; the old budget
    of 50 STATUSINT reads was ~3.2 ms. Now bounded by time (100 ms), with
    CTRL8.bit7 set so STATUSINT.bit7 is the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
    [app_main.c, i2c_bus.c, qmi8658.c, qmi8658.h]
2026-09-27 Record the firmware skeleton's measurements, amend 6.2 for data-ready pacing
    0 of 54,653 samples lost in 60 s at rest. Rendering pushes the read latency
    past the sample period, and together with streaming lost 0.72%; with the gate
    armed the same load lost none and latency peaked at 820 us. Also recorded:
    the map check and its canary, INT2_EN and the CTRL9 timing that rev A does not
    give, the stuck-bus recovery, and the one done-means still open (Will's look
    at the screens).
2026-09-27 Split the read latency into its three segments in the jitter report
    Edge to task running, the STATUSINT read, and the lock wait plus burst,
    each with its own histogram (in PSRAM: diagnostic counts, kept out of the
    internal budget the acquisition path uses). With rendering on core 1 the
    STATUSINT read grew 158 us at the median and the burst only 54, although
    the burst moves 17 bytes to its one: code gone cold, not a slower bus.
    [acq.c, qmi8658.c, qmi8658.h, stream.c]
2026-09-27 Run the I2C master driver from IRAM: rendering was evicting it
    Rendering on core 1 evicted the driver's task-side code from the cache the
    two cores share, and the first I2C transfer of every IMU sample paid the
    misses. With i2c_master and i2c_hal in IRAM (ESP-IDF keeps only the ISR
    there), animating: latency p50 930 -> 700 us (armed: 700), max 1156 -> 1026
    us, under the 1103 us period. Streaming while animating: 391 of 54,568
    samples lost before, 0 of 55,064 after. Costs about 12 KB of internal RAM.
2026-09-27 Record where rendering's delay came from, and what is left
    Two causes, each confirmed by changing one thing: the I2C driver evicted
    from the shared cache (fixed, IRAM), and touch polling on the shared bus
    (the remaining tail; the gate covers strokes). Also recorded: samples lost
    in the first second after boot, 10 of 12 boots, cause untested.
2026-09-28 WIP: port pivot.c -- test and C written, harness ops not yet
    Tests are red on purpose: test_c_pivot.py fails with "unknown op:
    pivreset" until portcheck.c learns the pivot commands. HANDOFF.md,
    next task 1, lists exactly what is left and in what order, and records
    Will's decision to measure the sample rate at startup.
    [cbuild.py]
2026-09-28 Finish the pivot.c port: harness ops, both precisions measured
    portcheck.c learns the pivot and calibration commands. Against NumPy on
    the pipeline's own pivot inputs, double matches the normal equations to
    3.4e-16 and the offset to 2.4e-13 m; float differs by at most 0.53 mm
    per stroke and 0.11 mm over a ten-stroke session. Ground truth holds in
    the C: rank-deficient swing, noise-only direction, 4.5 mm on ten noisy
    arced strokes.
    The single-precision test does not compare rank. For a single-axis
    swing the two directions perpendicular to the axis carry exactly equal
    energy, so the per-direction significance test depends on an arbitrary
    eigenbasis there; float dropped a 0.55 mm component dou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
2026-09-28 Port the pipeline to C: pipeline.c, verified against NumPy and truth
    The last layer of the C port. Fed the simulator's int16 counts, the C
    matches the Python exactly in double over 14 strokes -- address
    references, every stroke boundary, the impact attitude, face angle and
    tempo -- and to 3e-15 m on arc and travel, the one place it departs on
    purpose: the path window lives in a ring, so the track is summed from
    the window start rather than from address. Single precision, the first
    whole-pipeline measurement: 3.3e-5 deg of face angle, 8.7e-8 of tempo,
    0.035% of arc, no boundary moved, no direction changed.
    What the Python never had to decide, and how the C decides it: a stroke
    that outruns t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
2026-09-28 Measure the IMU's sample rate on the board at startup; amend 6.4
    Will's decision of 2026-09-27. acq/rate.c fits DRDY edge times against
    the sensor's own sample index over the first 1,024 samples after boot:
    lost samples thin the fit instead of biasing it, records where the task
    fell behind are skipped, and mispaired edges are rejected at 5 robust
    sigmas. Eight host tests against generated ground truth, including that
    the reported error matches the real scatter (z SD 1.00 over 60 runs).
    On the board: 906.9314 Hz, 30 back-to-back measurements within 1.0 ppm
    (SD 0.28 ppm -- the oscillator wandering, 8x the fit's own error). Timed
    against the PC's clock instead, 13.4 ppm higher: the two crystal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
    [app_main.c, cbuild.py, rate.c, rate_check.py, stream.c, stream.h]
2026-09-28 Add impact speed, the fourth metric: Python first, then the C
    Parent spec 1.2.1 made it a first-build metric; nothing computed it.
    |omega x (d + r)| -- the face as a point of the rigid body rotating about
    the fitted pivot -- at the last downswing sample before the impact
    spike, because from the spike on the gyro reads the collision too.
    Unavailable without a pivot solution: the lever arm alone reads 39% low.
    Against the generator's true face speed: <= 0.16% noiselessly over
    0.49-3.29 m/s, worst 0.70% at the board's noise floor, < 0.2% across
    putter types. The C matches the Python to 2.7e-15 m/s in double and
    5.9e-6 relative in float.
    The spec has no accuracy target for it in section 3; rec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
2026-09-29 Abandon strokes that never reach impact; add the session loop; amend 7.1
    Will's decision. The state machine only ran forward, so a practice
    stroke waited in DOWNSWING forever for an impact that never came, with
    rendering suspended. Now a stroke that has not reached impact is
    abandoned when the putter comes back to rest, or after a maximum stroke
    duration (a labelled placeholder, like every threshold). After impact a
    timeout finishes the stroke with what impact fixed and path unavailable.
    "Back at rest" is the address test run both ways: the window must fail
    it, then pass again. The first version -- motion seen, then any still
    window -- abandoned every real stroke at birth, because at onset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
    [cbuild.py]
2026-09-29 Run the stroke pipeline on the board; trim LVGL to make room; amend 6.2, 6.3
    firmware/main/stroke.c: a pl_session on the app task (core 1, per 6.2),
    fed from the ring drain once the startup rate exists, driving the render
    gate from BACKSWING through FOLLOWTHROUGH (Will's decision; arming at
    ADDRESS would freeze swipes whenever the putter lay still). Results to
    the screens and the console; abandons reported; samples lost mid-stroke
    counted and reported with the stroke, since the pipeline cannot see a gap.
    The placeholders -- every threshold and the lever arm -- live in one
    file, main/stroke_config.c, and test_stroke_config.py fails if they
    drift from the Python's Thresholds().
    Memory: the 1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
    [app_main.c, stream.c, stroke.c]
2026-11-06 Add session stroke logging to a raw partition; fix the zig cc build; amend 11
    Spec 11 amended (Will's decisions): record sessions, not strokes, so the
    corpus is not selected by the placeholder thresholds it exists to derive;
    on a raw append-only partition, not LittleFS, because a flash erase stalls
    both cores and would drop samples.
    - components/rec: lossless block encoder (per-axis differences, Rice-coded,
    64-sample blocks with CRCs) and an append-only log that programs one
    256-byte page per app-loop pass while recording.
    - plumb/corpus.py decodes it, written from the design doc.
    tests/test_rec.py: 28 tests, samples round-trip bit for bit through the
    C and the Python, including ind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
2026-11-06 Add a README: what Plumb measures, how it is built, what is proven and not
    Every result is labelled by source (synthetic, host harness, board); none
    comes from a real putt, and the table of what is not done says so.
